AdejireA/solar-energy-monitoring-system/(commit log)

2026-09-28 Add hardware photos and circuit schematics
2026-09-30 Clarify prototype deployment terminology
